Samrajp/DESIGN-AND-FABRICATION-OF-DISC-TYPE-HYBRID-TURBINE-PUMP/DESIGN AND FABRICATION OF DISC TYPE HYBRID  TURBINE-PUMP/DISC TYPE HYBRID  TURBINE-PUMP/Intake_Side.SLDASM

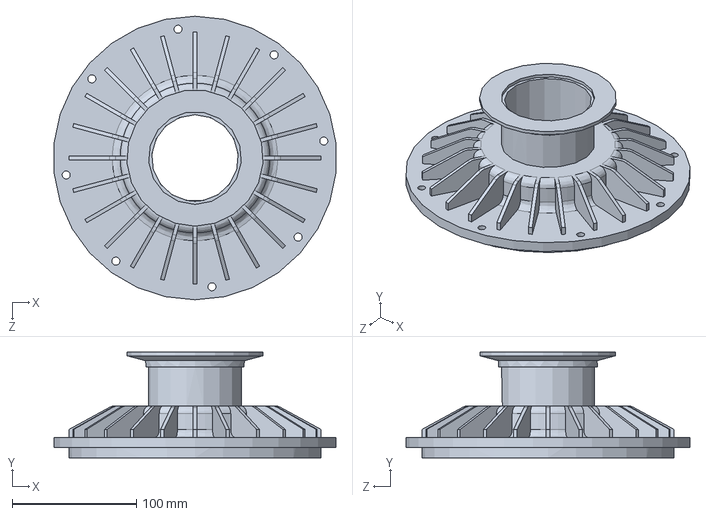
[picture p25: CAD file, 2022-06-21]
DESIGN AND FABRICATION OF DISC TYPE HYBRID TURBINE-PUMP/DISC TYPE HYBRID TURBINE-PUMP/Intake_Side.SLDASM
227.3 x 85.1 x 228.6 mm
intake_End
AI_TCR1_44TP030_0_1
