Samrajp/DESIGN-AND-FABRICATION-OF-DISC-TYPE-HYBRID-TURBINE-PUMP/DESIGN AND FABRICATION OF DISC TYPE HYBRID  TURBINE-PUMP/DISC TYPE HYBRID  TURBINE-PUMP/E_Housing.SLDASM

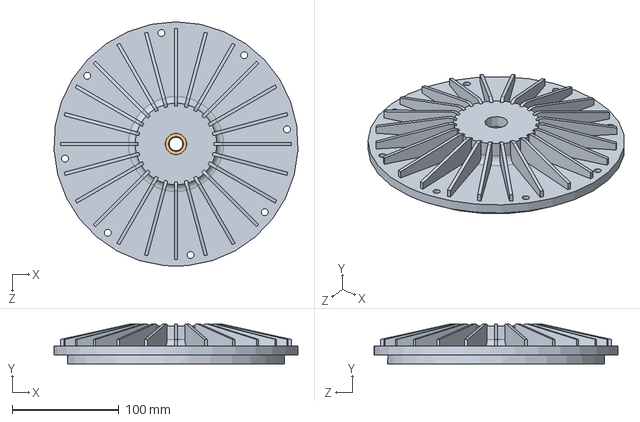
[picture p26: CAD file, 2022-06-21]
DESIGN AND FABRICATION OF DISC TYPE HYBRID TURBINE-PUMP/DISC TYPE HYBRID TURBINE-PUMP/E_Housing.SLDASM
228.3 x 37.2 x 228.6 mm
End_Closed
MBBF-12-34-12
