Samrajp/DESIGN-AND-FABRICATION-OF-DISC-TYPE-HYBRID-TURBINE-PUMP/DESIGN AND FABRICATION OF DISC TYPE HYBRID  TURBINE-PUMP/DISC TYPE HYBRID  TURBINE-PUMP/disk turbine.SLDASM

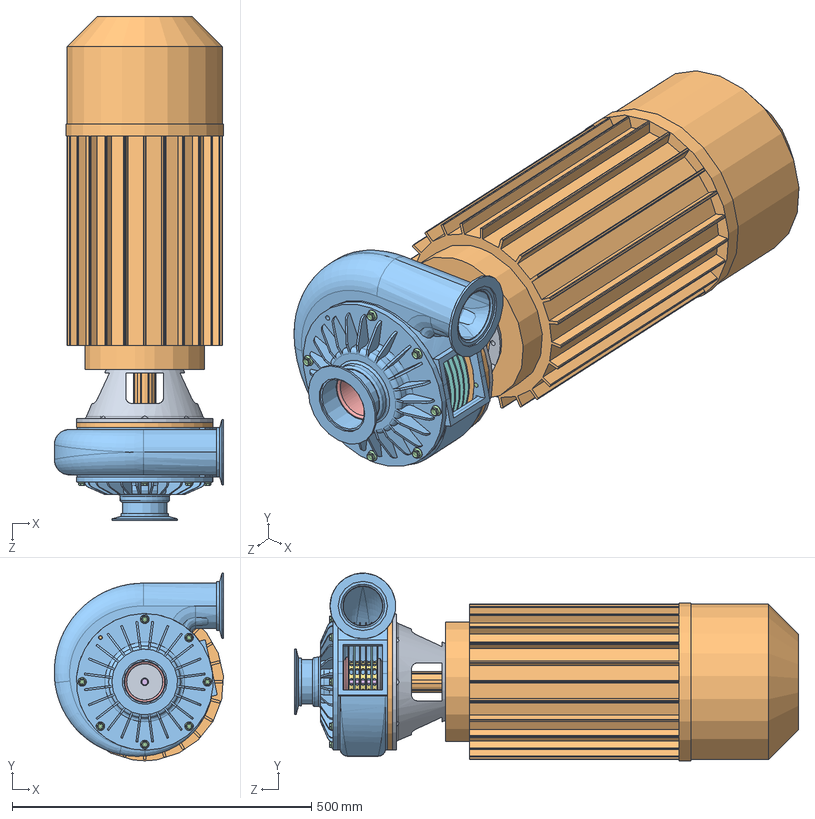
[picture p27: CAD file, 2022-06-21]
DESIGN AND FABRICATION OF DISC TYPE HYBRID TURBINE-PUMP/DISC TYPE HYBRID TURBINE-PUMP/disk turbine.SLDASM
283.4 x 313.8 x 842.7 mm
scroll
End_Closed
MBBF-12-34-12
spindle
disk80 x 6
Ring x 5
bolt25
Intake_Spindle
Flange bolt_USA x 16
intake_End
AI_TCR1_44TP030_0_1
Pump-motor
Adapter
