Samrajp/DESIGN-AND-FABRICATION-OF-DISC-TYPE-HYBRID-TURBINE-PUMP/DESIGN AND FABRICATION OF DISC TYPE HYBRID  TURBINE-PUMP/DISC TYPE HYBRID  TURBINE-PUMP/disk_set.SLDASM

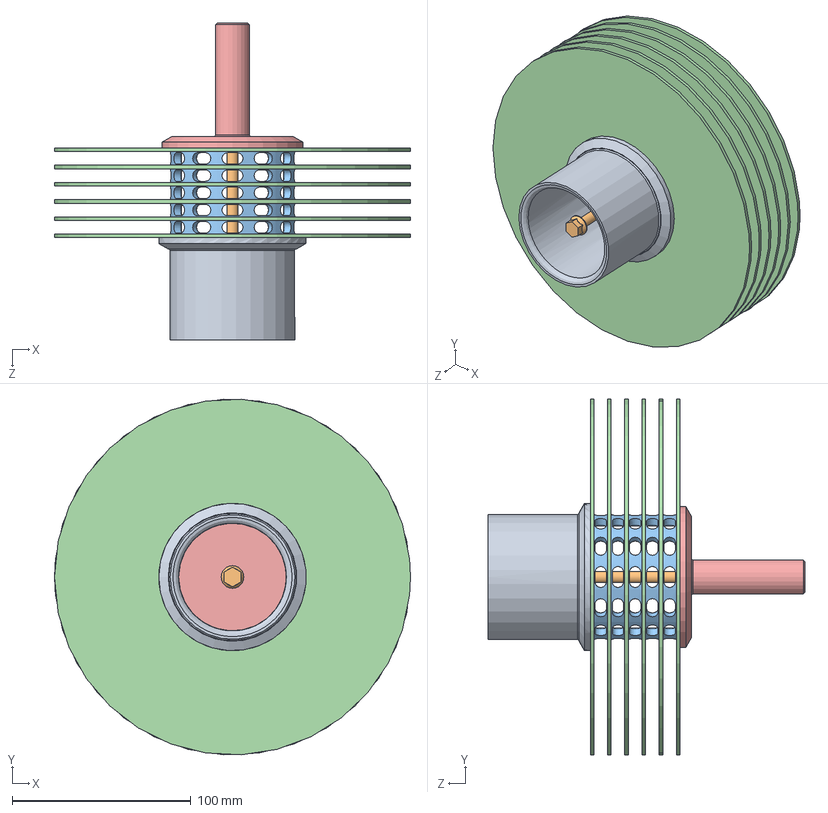
[picture p28: CAD file, 2022-06-21]
DESIGN AND FABRICATION OF DISC TYPE HYBRID TURBINE-PUMP/DISC TYPE HYBRID TURBINE-PUMP/disk_set.SLDASM
199.4 x 199.1 x 177.3 mm
spindle
disk80 x 6
Ring x 5
bolt25
Intake_Spindle
