Samrajp/DESIGN-AND-FABRICATION-OF-DISC-TYPE-HYBRID-TURBINE-PUMP/DESIGN AND FABRICATION OF DISC TYPE HYBRID  TURBINE-PUMP/DISC TYPE HYBRID  TURBINE-PUMP/scroll.SLDPRT

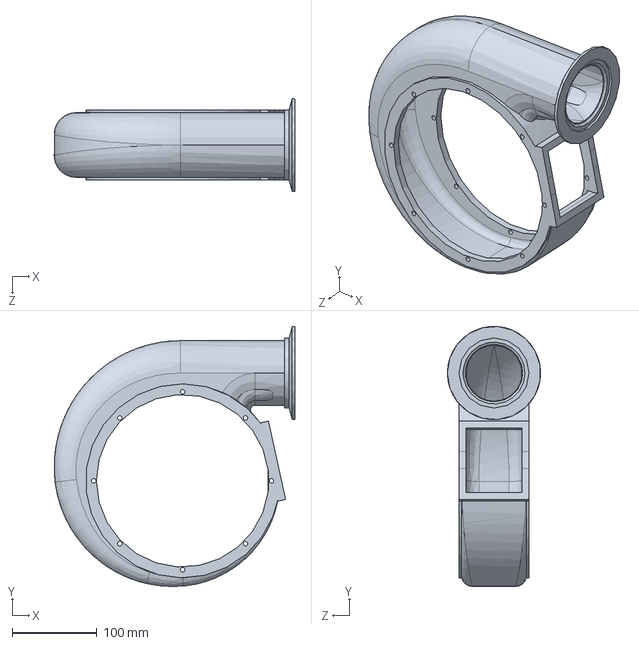
[picture p29: CAD file, 2022-06-21]
DESIGN AND FABRICATION OF DISC TYPE HYBRID TURBINE-PUMP/DISC TYPE HYBRID TURBINE-PUMP/scroll.SLDPRT
283.4 x 306.3 x 110.0 mm
